slapab/sanwaPC5000aInterface/hardware/documentation/ir_converter-top-3D.png

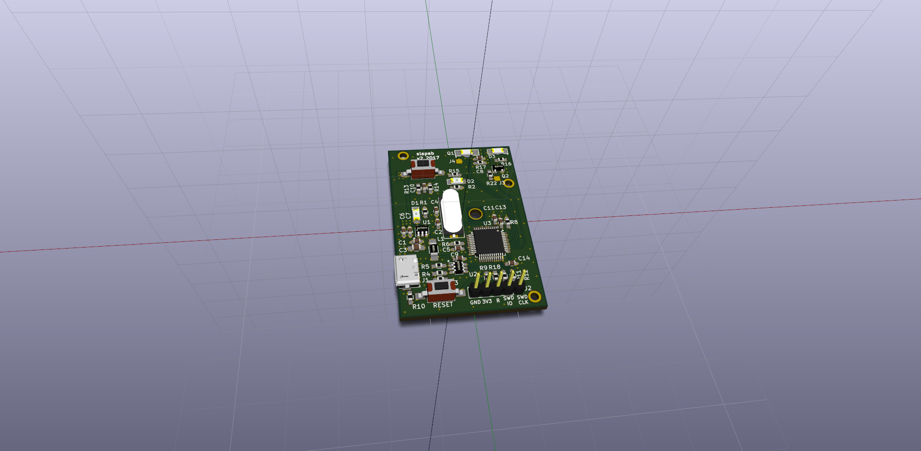
hardware/documentation/ir_converter-top-3D.png
