slapab/sanwaPC5000aInterface/hardware/ir_converter.kicad_pcb

## KiCad design hardware/ir_converter.kicad_pcb (2017-11-12)

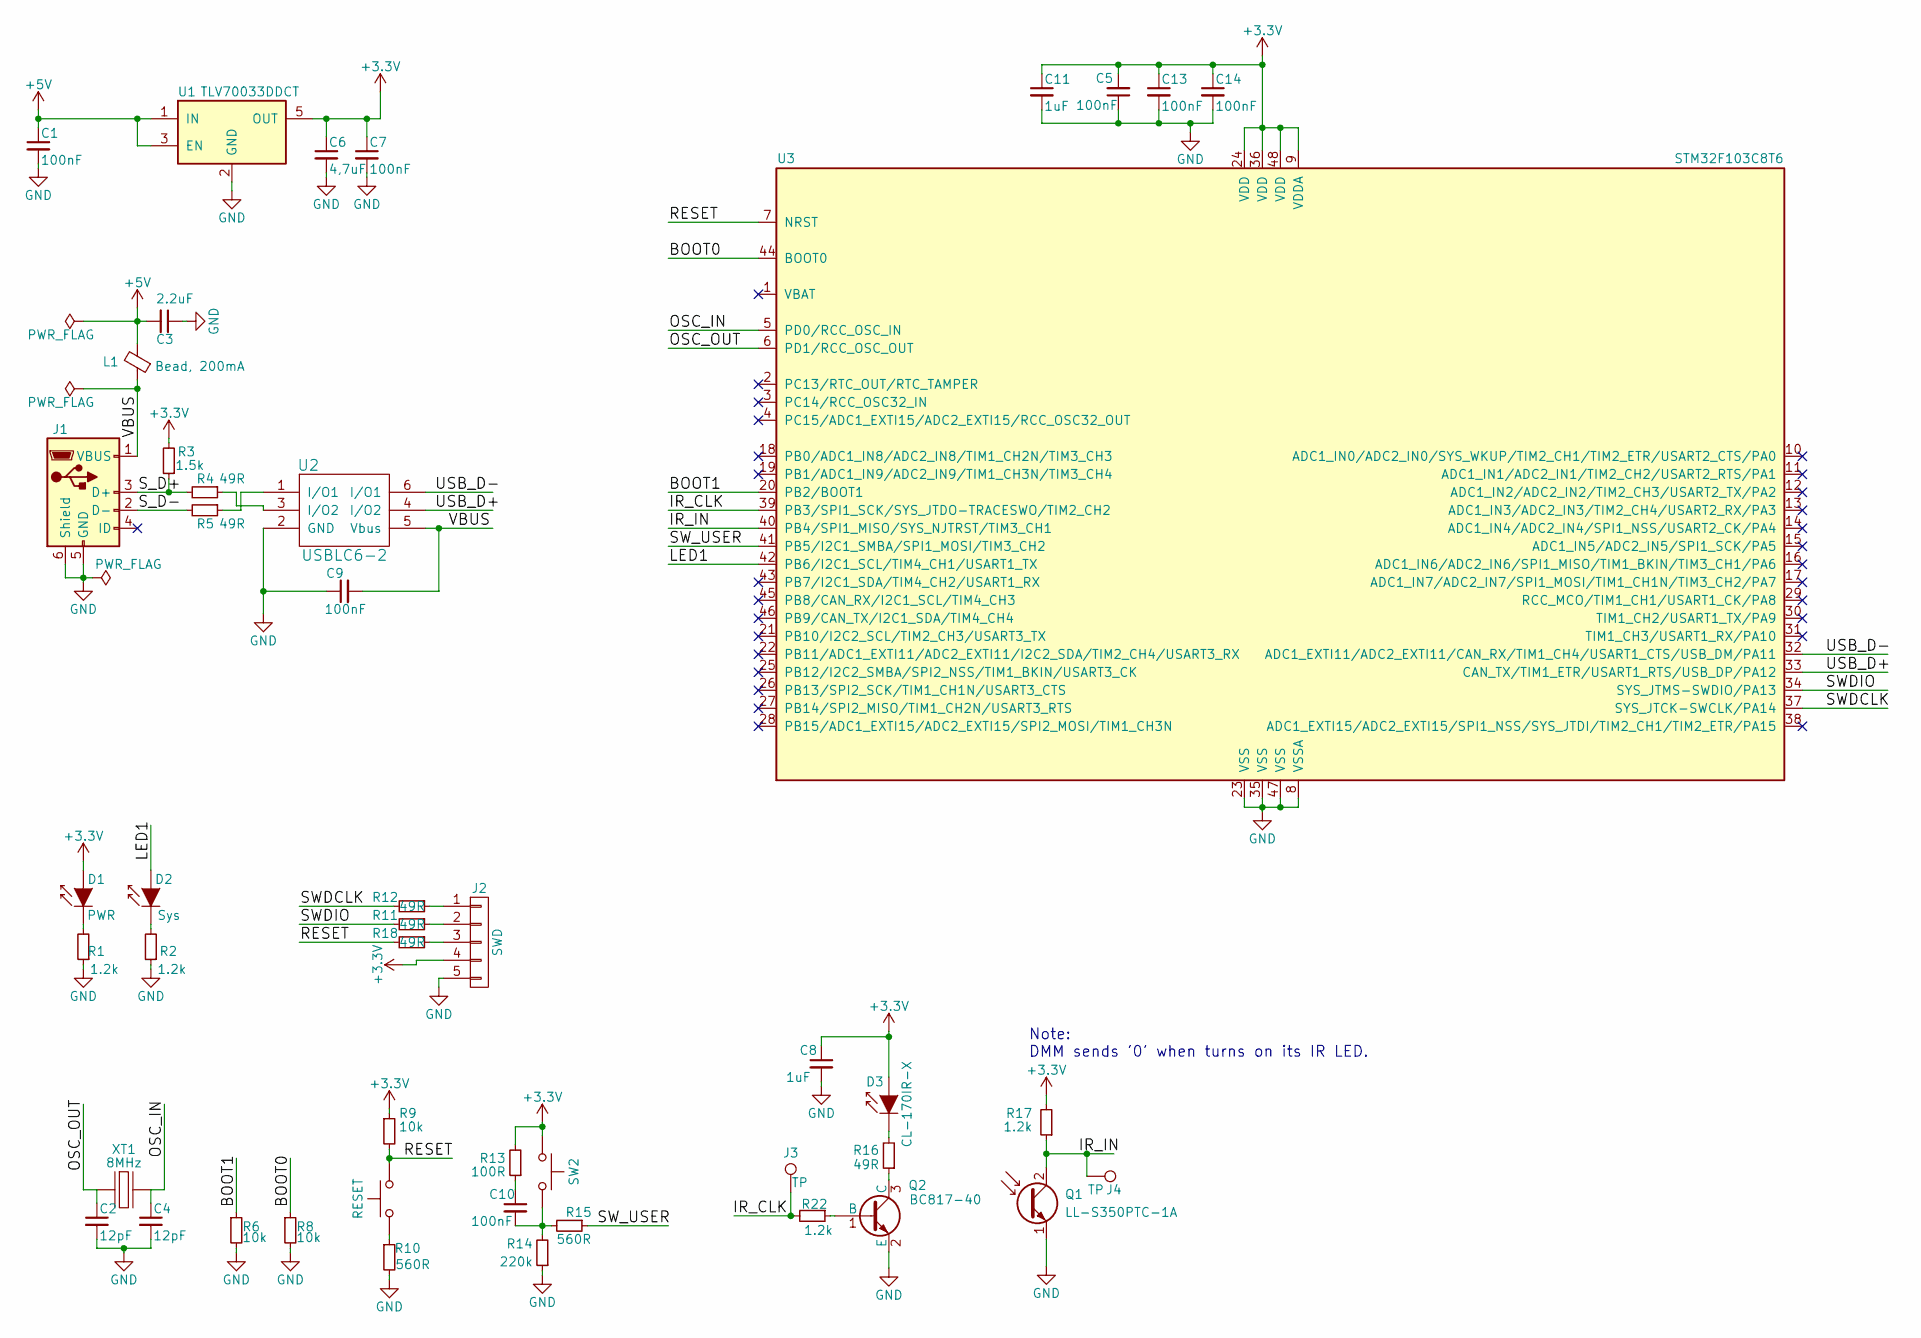
[picture p3: schematic ir_converter.sch]

Parts:
C1, C5, C7, C9, C10, C13, C14: 100nF; C_0603_HandSoldering
C2, C4: 12pF; C_0603_HandSoldering
C3: 2.2uF; C_0805_HandSoldering
C6: 4,7uF; C_0603_HandSoldering
C8, C11: 1uF; C_0603_HandSoldering
D1: PWR; LED_1206
D2: Sys; LED_1206
D3: CL-170IR-X; IR_LED_WIDE
J1: MX-47346-0001; USB_MICRO_MX-47346-0001
J2: SWD; Pin_Header_Straight_1x05_Pitch2.54mm
J3, J4: TP; Measurement_Point_Square-SMD-Pad_Small
L1: Bead, 200mA; L_1206_Handsoldering
Q1: LL-S350PTC-1A; IR_PHOTO_WIDE
Q2: BC817-40; SOT-23
R1, R2, R17, R22: 1.2k; R_0603_HandSoldering
R3: 1.5k; R_0603_HandSoldering
R4, R5, R11, R12, R16, R18: 49R; R_0603_HandSoldering
R6, R8, R9: 10k; R_0603_HandSoldering
R10, R15: 560R; R_0603_HandSoldering
R13: 100R; R_0603_HandSoldering
R14: 220k; R_0603_HandSoldering
SW1: RESET; SW_SPST_FSMSM
SW2: SW2; SW_SPST_FSMSM
U1: TLV70033DDCT; SOT-23-5
U2: USBLC6-2; SOT-23-6_Handsoldering
U3: STM32F103C8T6; LQFP-48_7x7mm_Pitch0.5mm
XT1: 8MHz; Crystal_SMD_HC49-SD

Connections:
+3V3: C5.2, C6.1, C7.1, C8.1, C11.1, C13.1, C14.1, D1.2 (A), D3.2 (A), J2.4, R3.2, R9.1, R13.2, R17.2, SW2.1, U1.5 (OUT), U3.9 (VDDA), U3.24 (VDD), U3.36 (VDD), U3.48 (VDD)
+5V: C1.1, C3.2, L1.2, U1.1 (IN), U1.3 (EN)
/BOOT0: R8.1, U3.44 (BOOT0)
/BOOT1: R6.1, U3.20 (PB2/BOOT1)
/IR_CLK: J3.1, R22.2, U3.39 (PB3/SPI1_SCK/SYS_JTDO-TRACESWO/TIM2_CH2)
/IR_IN: J4.1, Q1.2 (C), R17.1, U3.40 (PB4/SPI1_MISO/SYS_NJTRST/TIM3_CH1)
/LED1: D2.2 (A), U3.42 (PB6/I2C1_SCL/TIM4_CH1/USART1_TX)
/OSC_IN: C4.1, U3.5 (PD0/RCC_OSC_IN), XT1.2
/OSC_OUT: C2.1, U3.6 (PD1/RCC_OSC_OUT), XT1.1
/RESET: R9.2, R18.2, SW1.2, U3.7 (NRST)
/SWDCLK: R12.2, U3.37 (SYS_JTCK-SWCLK/PA14)
/SWDIO: R11.2, U3.34 (SYS_JTMS-SWDIO/PA13)
/SW_USER: R15.1, U3.41 (PB5/I2C1_SMBA/SPI1_MOSI/TIM3_CH2)
/S_D+: J1.3 (D+), R3.1, R4.2
/S_D-: J1.2 (D-), R5.2
/USB_D+: U2.4 (I/O2), U3.33 (CAN_TX/TIM1_ETR/USART1_RTS/USB_DP/PA12)
/USB_D-: U2.6 (I/O1), U3.32 (ADC1_EXTI11/ADC2_EXTI11/CAN_RX/TIM1_CH4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)
/VBUS: C9.2, J1.1 (VBUS), L1.1, U2.5 (Vbus)
GND: C1.2, C2.2, C3.1, C4.2, C5.1, C6.2, C7.2, C8.2, C9.1, C11.2, C13.2, C14.2, J1.5 (GND), J1.6 (Shield), J2.5, Q1.1 (E), Q2.2 (E), R1.1, R2.1, R6.2, R8.2, R10.2, R14.1, U1.2 (GND), U2.2 (GND), U3.8 (VSSA), U3.23 (VSS), U3.35 (VSS), U3.47 (VSS)
unnamed: C10.1, R13.1
unnamed: C10.2, R14.2, R15.2, SW2.2
unnamed: D1.1 (K), R1.2
unnamed: D2.1 (K), R2.2
unnamed: D3.1 (K), R16.2
unnamed: J2.1, R12.1
unnamed: J2.2, R11.1
unnamed: J2.3, R18.1
unnamed: Q2.1 (B), R22.1
unnamed: Q2.3 (C), R16.1
unnamed: R4.1, U2.3 (I/O2)
unnamed: R5.1, U2.1 (I/O1)
unnamed: R10.1, SW1.1

Notes on the sheet:
Note: DMM sends '0' when turns on its IR LED.

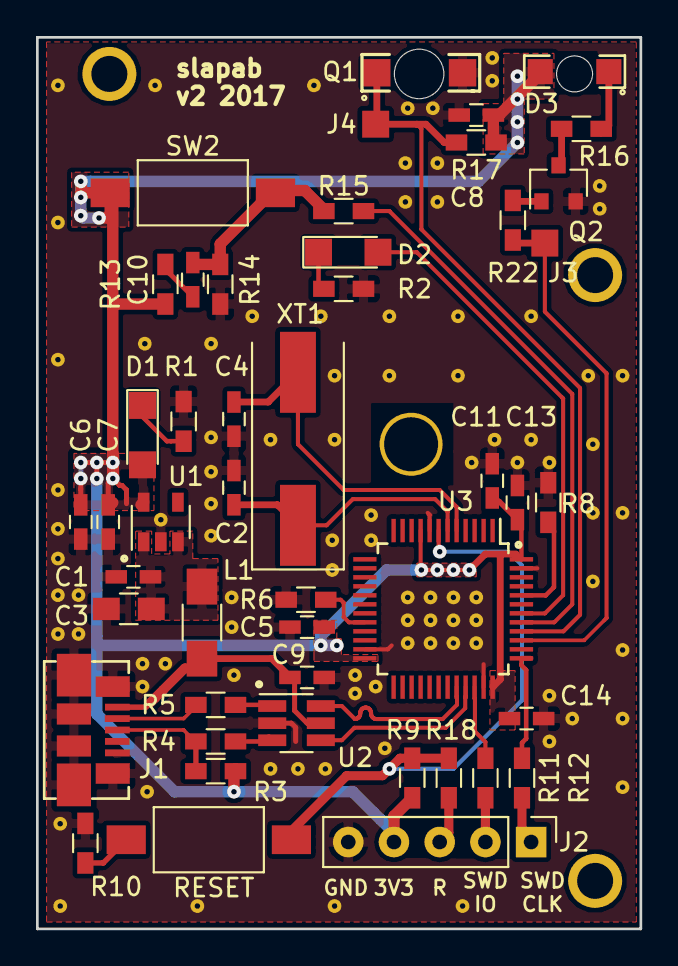
[picture p4: board ir_converter.kicad_pcb from above]

Board: 2 copper layers, 33.5 x 49.5 mm, 47 parts (0 on the bottom side), 32 nets.
