slapab/sanwaPC5000aInterface/firmware/usbdfu_bootloader/main.c

/*
 * This file is part of the libopencm3 project.
 *
 * Copyright (C) 2010 Gareth McMullin <gareth@blacksphere.co.nz>
 *
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
 * You should have received a copy of the GNU Lesser General Public License
 * along with this library.  If not, see <http://www.gnu.org/licenses/>.
 */

#include <string.h>
#include <libopencm3/stm32/rcc.h>
#include <libopencm3/stm32/gpio.h>
#include <libopencm3/stm32/flash.h>
#include <libopencm3/cm3/scb.h>
#include <libopencm3/usb/usbd.h>
#include <libopencm3/usb/dfu.h>

#define APP_ADDRESS 0x08002000

/* Commands sent with wBlockNum == 0 as per ST implementation. */
#define CMD_SETADDR 0x21
#define CMD_ERASE   0x41

/// Port to which user button is connected to
#define USER_BT_PORT GPIOB
/// Pin to which user button is connected to
#define USER_BT_PIN GPIO5
// Port to which user LED is connected to
#define USER_LED_PORT GPIOB
// Pin to which user LED is connected to
#define USER_LED_PIN GPIO6

/* We need a special large control buffer for this device: */
uint8_t usbd_control_buffer[1024];

static enum dfu_state usbdfu_state = STATE_DFU_IDLE;

static struct {
    uint8_t buf[sizeof(usbd_control_buffer)];
    uint16_t len;
    uint32_t addr;
    uint16_t blocknum;
} prog;

const struct usb_device_descriptor dev = {
    .bLength = USB_DT_DEVICE_SIZE,
    .bDescriptorType = USB_DT_DEVICE,
    .bcdUSB = 0x0200,
    .bDeviceClass = 0,
    .bDeviceSubClass = 0,
    .bDeviceProtocol = 0,
    .bMaxPacketSize0 = 64,
    .idVendor = 0x0483,
    .idProduct = 0xDF11,
    .bcdDevice = 0x0200,
    .iManufacturer = 1,
    .iProduct = 2,
    .iSerialNumber = 3,
    .bNumConfigurations = 1,
};

const struct usb_dfu_descriptor dfu_function = {
    .bLength = sizeof(struct usb_dfu_descriptor),
    .bDescriptorType = DFU_FUNCTIONAL,
    .bmAttributes = USB_DFU_CAN_DOWNLOAD | USB_DFU_WILL_DETACH,
    .wDetachTimeout = 255,
    .wTransferSize = 1024,
    .bcdDFUVersion = 0x011A,
};

const struct usb_interface_descriptor iface = {
    .bLength = USB_DT_INTERFACE_SIZE,
    .bDescriptorType = USB_DT_INTERFACE,
    .bInterfaceNumber = 0,
    .bAlternateSetting = 0,
    .bNumEndpoints = 0,
    .bInterfaceClass = 0xFE, /* Device Firmware Upgrade */
    .bInterfaceSubClass = 1,
    .bInterfaceProtocol = 2,

    /* The ST Microelectronics DfuSe application needs this string.
     * The format isn't documented... */
    .iInterface = 4,

    .extra = &dfu_function,
    .extralen = sizeof(dfu_function),
};

const struct usb_interface ifaces[] = {{
    .num_altsetting = 1,
    .altsetting = &iface,
}};

const struct usb_config_descriptor config = {
    .bLength = USB_DT_CONFIGURATION_SIZE,
    .bDescriptorType = USB_DT_CONFIGURATION,
    .wTotalLength = 0,
    .bNumInterfaces = 1,
    .bConfigurationValue = 1,
    .iConfiguration = 0,
    .bmAttributes = 0xC0,
    .bMaxPower = 0x32,

    .interface = ifaces,
};

static const char *usb_strings[] = {
    "Black Sphere Technologies",
    "DFU Demo",
    "DEMO",
    /* This string is used by ST Microelectronics' DfuSe utility. */
    "@Internal Flash   /0x08000000/8*001Ka,56*001Kg",
};

static uint8_t usbdfu_getstatus(usbd_device *usbd_dev, uint32_t *bwPollTimeout)
{
    (void)usbd_dev;

    switch (usbdfu_state) {
    case STATE_DFU_DNLOAD_SYNC:
        usbdfu_state = STATE_DFU_DNBUSY;
        *bwPollTimeout = 100;
        return DFU_STATUS_OK;
    case STATE_DFU_MANIFEST_SYNC:
        /* Device will reset when read is complete. */
        usbdfu_state = STATE_DFU_MANIFEST;
        return DFU_STATUS_OK;
    default:
        return DFU_STATUS_OK;
    }
}

static void usbdfu_getstatus_complete(usbd_device *usbd_dev, struct usb_setup_data *req)
{
    int i;
    (void)req;
    (void)usbd_dev;

    switch (usbdfu_state) {
    case STATE_DFU_DNBUSY:
        flash_unlock();
        if (prog.blocknum == 0) {
            switch (prog.buf[0]) {
            case CMD_ERASE:
                {
                    uint32_t *dat = (uint32_t *)(prog.buf + 1);
                    flash_erase_page(*dat);
                }
            case CMD_SETADDR:
                {
                    uint32_t *dat = (uint32_t *)(prog.buf + 1);
                    prog.addr = *dat;
                }
            }
        } else {
            uint32_t baseaddr = prog.addr + ((prog.blocknum - 2) *
                       dfu_function.wTransferSize);
            for (i = 0; i < prog.len; i += 2) {
                uint16_t *dat = (uint16_t *)(prog.buf + i);
                flash_program_half_word(baseaddr + i,
                        *dat);
            }
        }
        flash_lock();

        /* Jump straight to dfuDNLOAD-IDLE, skipping dfuDNLOAD-SYNC. */
        usbdfu_state = STATE_DFU_DNLOAD_IDLE;
        return;
    case STATE_DFU_MANIFEST:
        /* USB device must detach, we just reset... */
        scb_reset_system();
        return; /* Will never return. */
    default:
        return;
    }
}

static int usbdfu_control_request(usbd_device *usbd_dev, struct usb_setup_data *req, uint8_t **buf,
        uint16_t *len, void (**complete)(usbd_device *usbd_dev, struct usb_setup_data *req))
{
    if ((req->bmRequestType & 0x7F) != 0x21)
        return 0; /* Only accept class request. */

    switch (req->bRequest) {
    case DFU_DNLOAD:
        if ((len == NULL) || (*len == 0)) {
            usbdfu_state = STATE_DFU_MANIFEST_SYNC;
            return 1;
        } else {
            /* Copy download data for use on GET_STATUS. */
            prog.blocknum = req->wValue;
            prog.len = *len;
            memcpy(prog.buf, *buf, *len);
            usbdfu_state = STATE_DFU_DNLOAD_SYNC;
            return 1;
        }
    case DFU_CLRSTATUS:
        /* Clear error and return to dfuIDLE. */
        if (usbdfu_state == STATE_DFU_ERROR)
            usbdfu_state = STATE_DFU_IDLE;
        return 1;
    case DFU_ABORT:
        /* Abort returns to dfuIDLE state. */
        usbdfu_state = STATE_DFU_IDLE;
        return 1;
    case DFU_UPLOAD:
        /* Upload not supported for now. */
        return 0;
    case DFU_GETSTATUS: {
        uint32_t bwPollTimeout = 0; /* 24-bit integer in DFU class spec */
        (*buf)[0] = usbdfu_getstatus(usbd_dev, &bwPollTimeout);
        (*buf)[1] = bwPollTimeout & 0xFF;
        (*buf)[2] = (bwPollTimeout >> 8) & 0xFF;
        (*buf)[3] = (bwPollTimeout >> 16) & 0xFF;
        (*buf)[4] = usbdfu_state;
        (*buf)[5] = 0; /* iString not used here */
        *len = 6;
        *complete = usbdfu_getstatus_complete;
        return 1;
        }
    case DFU_GETSTATE:
        /* Return state with no state transision. */
        *buf[0] = usbdfu_state;
        *len = 1;
        return 1;
    }

    return 0;
}

static void usbdfu_set_config(usbd_device *usbd_dev, uint16_t wValue)
{
    (void)wValue;

    usbd_register_control_callback(
                usbd_dev,
                USB_REQ_TYPE_CLASS | USB_REQ_TYPE_INTERFACE,
                USB_REQ_TYPE_TYPE | USB_REQ_TYPE_RECIPIENT,
                usbdfu_control_request);
}


static void rcc_clock_setup_in_hse_8mhz_out_48mhz(void)
{
    /* Enable external high-speed oscillator 8MHz. */
    rcc_osc_on(RCC_HSE);
    rcc_wait_for_osc_ready(RCC_HSE);
    rcc_set_sysclk_source(RCC_CFGR_SW_SYSCLKSEL_HSECLK);


    /*
     * Set prescalers for AHB, ADC, ABP1, ABP2.
     * Do this before touching the PLL
     */
    rcc_set_hpre(RCC_CFGR_HPRE_SYSCLK_NODIV);   /*Set.48MHz Max.72MHz */
    rcc_set_adcpre(RCC_CFGR_ADCPRE_PCLK2_DIV8); /*Set. 6MHz Max.14MHz */
    rcc_set_ppre1(RCC_CFGR_PPRE1_HCLK_DIV2);    /*Set.24MHz Max.36MHz */
    rcc_set_ppre2(RCC_CFGR_PPRE2_HCLK_NODIV);   /*Set.48MHz Max.72MHz */
    rcc_set_usbpre(RCC_CFGR_USBPRE_PLL_CLK_NODIV);  /*Set.48MHz Max.48MHz */

    /*
     * Sysclk runs with 24MHz -> 0 waitstates.
     * 0WS from 0-24MHz
     * 1WS from 24-48MHz
     * 2WS from 48-72MHz
     */
    flash_set_ws(FLASH_ACR_LATENCY_1WS);

    /*
     * Set the PLL multiplication factor to 6.
     * 8MHz (external) * 6 (multiplier) = 48MHz
     */
    rcc_set_pll_multiplication_factor(RCC_CFGR_PLLMUL_PLL_CLK_MUL6);

    /* Select HSE as PLL source. */
    rcc_set_pll_source(RCC_CFGR_PLLSRC_HSE_CLK);

    /*
     * External frequency undivided before entering PLL
     * (only valid/needed for HSE).
     */
    rcc_set_pllxtpre(RCC_CFGR_PLLXTPRE_HSE_CLK);

    /* Enable PLL oscillator and wait for it to stabilize. */
    rcc_osc_on(RCC_PLL);
    rcc_wait_for_osc_ready(RCC_PLL);

    /* Select PLL as SYSCLK source. */
    rcc_set_sysclk_source(RCC_CFGR_SW_SYSCLKSEL_PLLCLK);

    /* Set the peripheral clock frequencies used */
    rcc_ahb_frequency = 48000000;
    rcc_apb1_frequency = 24000000;
    rcc_apb2_frequency = 48000000;
}



int main(void)
{ 
	rcc_clock_setup_in_hse_8mhz_out_48mhz();

	usbd_device *usbd_dev;

    // try to force re-enumeration by host
    {
        rcc_periph_clock_enable(RCC_GPIOA);
        // PA11 -> D-
        // PA12 -> D+
        gpio_set_mode(GPIOA, GPIO_MODE_OUTPUT_2_MHZ,
                  GPIO_CNF_OUTPUT_PUSHPULL, GPIO11);
        gpio_set_mode(GPIOA, GPIO_MODE_OUTPUT_2_MHZ,
                  GPIO_CNF_OUTPUT_PUSHPULL, GPIO12);

        // simulate repluging of the device
        gpio_clear(GPIOA, GPIO12);
        gpio_clear(GPIOA, GPIO11);
        for (int i = 500; i--;)
        {
        	asm("nop");
        }

        // configure as input -> lets the pulls do the job
        gpio_set_mode(GPIOA, GPIO_MODE_INPUT, 0, GPIO11);
        gpio_set_mode(GPIOA, GPIO_MODE_INPUT, 0, GPIO12);
    }

    rcc_periph_clock_enable(RCC_GPIOB);
    gpio_set_mode(USER_BT_PORT, GPIO_MODE_INPUT, GPIO_CNF_INPUT_FLOAT, USER_BT_PIN);
    gpio_set_mode(USER_LED_PORT, GPIO_MODE_OUTPUT_2_MHZ, GPIO_CNF_OUTPUT_PUSHPULL, USER_LED_PIN);

    // wait some time before checking user button
    for (int i = 48000; i--;)
    {
    	asm("nop");
    }

    if (0 == (gpio_get(USER_BT_PORT, USER_BT_PIN) & USER_BT_PIN)) {
        /* Boot the application if it's valid. */
        if ((*(volatile uint32_t *)APP_ADDRESS & 0x2FFE0000) == 0x20000000) {
            /* Set vector table base address. */
            SCB_VTOR = APP_ADDRESS & 0xFFFF;
            /* Initialise master stack pointer. */
            asm volatile("msr msp, %0"::"g"
                     (*(volatile uint32_t *)APP_ADDRESS));
            /* Jump to application. */
            (*(void (**)())(APP_ADDRESS + 4))();
        }
    }

    // rcc_clock_setup_in_hsi_out_48mhz();

    gpio_set(USER_LED_PORT, USER_LED_PIN); // user led off

    usbd_dev = usbd_init(&st_usbfs_v1_usb_driver, &dev, &config, usb_strings, 4, usbd_control_buffer, sizeof(usbd_control_buffer));
    usbd_register_set_config_callback(usbd_dev, usbdfu_set_config);

    gpio_clear(USER_LED_PORT, USER_LED_PIN); // led on

    uint32_t d = 0;
    while (1) {
        usbd_poll(usbd_dev);

        ++d;
        if (d >= 480000) {
            d = 0;
            gpio_toggle(USER_LED_PORT, USER_LED_PIN);
        }
    }
}
