slapab/sanwaPC5000aInterface/(commit log)

2017-03-21 Added Unity framewor for unit testing. Created directory for application's tests. Updated bm_dmm_protocol.c/.h files to compile unit-tests project.
2017-03-22 Added few tests. Fixed calculating checksum in brymen protocol.
    [bm_dmm_protocol.c]
2017-03-22 Added all required tests for bm_dmm_protocol.c/.h. And fixed some issues.
    [bm_dmm_protocol.c, bm_dmm_protocol.h]
2017-03-26 Inserting read bits from IR receiver into buffer. Not tested yet.
2017-04-07 Added first version of hardware
    [ir_converter.kicad_pcb, ir_converter.sch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]
2017-04-08 Changed ground plane clearance
    [ir_converter-B.Cu.gbr, ir_converter-B.SilkS.gbr, ir_converter-Edge.Cuts.gbr, ir_converter-F.CrtYd.gbr, ir_converter-F.Cu.gbr, ir_converter-F.Fab.gbr, ir_converter-F.Mask.gbr, ir_converter-F.Paste.gbr]
2017-04-09 Updated project to work on hardware v0.1. Also fixes some bugs.
    [bsp.c, bsp.h, ir_interface.c, main.c, systick_local.c]
2017-04-23 Fixed setting custom callback for usb-rx event. First attemption to use timer to generate the CLK signal and collect data on falling edge. Code NEEDS cleaning!
    [ir_interface.c, ir_interface.h, main.c]
2017-05-03 Added simple software timers implementation
2017-05-03 ir-interface - the non-blocking reading data uses software timer to prevent hanging out when DMM didn't respond for data request signal.
    [ir_interface.c, ir_interface.h, main.c]
2017-05-03 Added npn tranistor to drive the IR LED.
    [ir_converter-B.Cu.gbr, ir_converter-B.SilkS.gbr, ir_converter-Edge.Cuts.gbr, ir_converter-F.CrtYd.gbr, ir_converter-F.Cu.gbr, ir_converter-F.Fab.gbr, ir_converter-F.Mask.gbr, ir_converter-F.Paste.gbr]
2017-05-23 Added bug fixes on schematic. Redesigning PCB.
    [ir_converter.kicad_pcb, ir_converter.sch]
2017-05-24 Elements arrangement.
    [ir_converter.kicad_pcb, ir_converter.sch]
2017-05-25 Almost done.
    [ir_converter.kicad_pcb, ir_converter.sch]
2017-05-25 Custom footprints for IR LED and IR phototransistor
2017-05-26 New PCB is ready.
    [ir_converter.kicad_pcb, ir_converter.sch]
2017-05-26 Generated documentation files
    [ir_converter-B.Cu.gbl, ir_converter-B.Cu.gbr, ir_converter-B.Mask.gbs, ir_converter-B.SilkS.gbo, ir_converter-Edge.Cuts.gbr, ir_converter-Edge.Cuts.gm1, ir_converter-F.CrtYd.gbr, ir_converter-F.Cu.gbr]
2017-05-26 Added schematic
2017-07-02 Prepared for fabrication
    [ir_converter-B.Cu.gbl, ir_converter-B.Mask.gbs, ir_converter-B.SilkS.gbo, ir_converter-Edge.Cuts.gm1, ir_converter-F.Cu.gtl, ir_converter-F.Mask.gts, ir_converter-F.SilkS.gto, ir_converter.drl]
2017-11-12 Resizing mouting holes
    [ir_converter-B.Cu.gbl, ir_converter-B.Mask.gbs, ir_converter-B.SilkS.gbo, ir_converter-Edge.Cuts.gm1, ir_converter-F.CrtYd.gbr, ir_converter-F.Cu.gtl, ir_converter-F.Fab.gbr, ir_converter-F.Mask.gts]
